juchong/EVAL-ADIS-FX3-Production-Test/images/disconnected.jpg

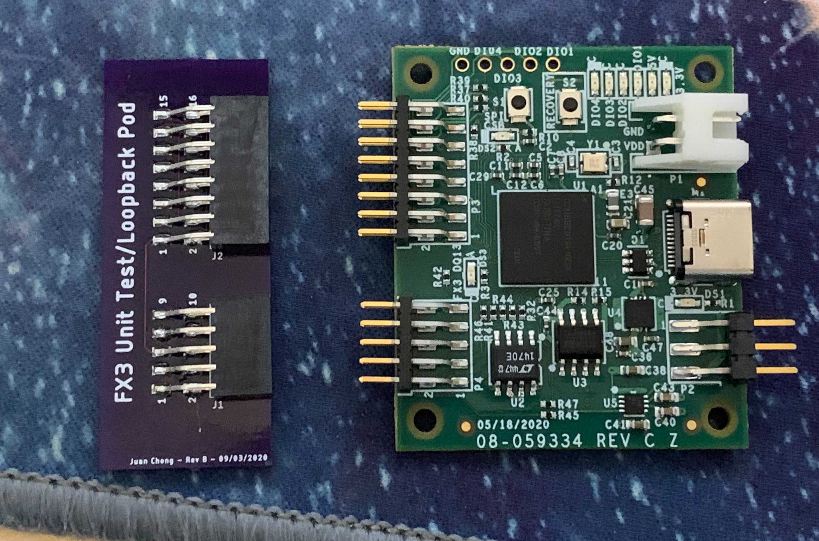
images/disconnected.jpg
