juchong/EVAL-ADIS-FX3-Production-Test/images/finished.PNG

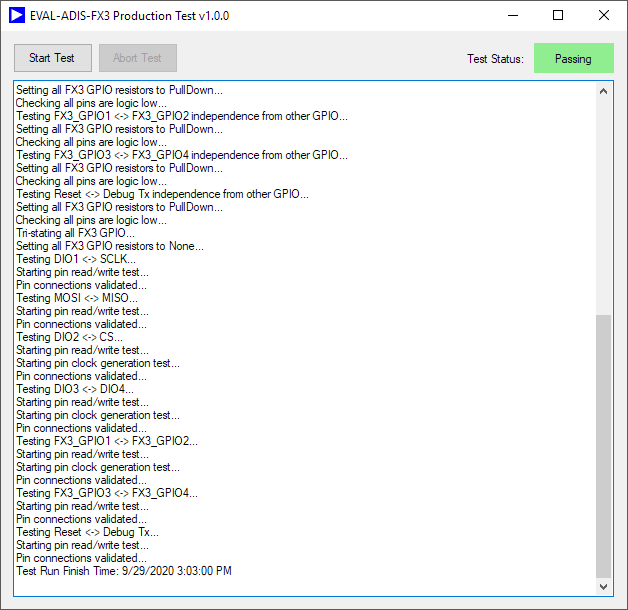
images/finished.PNG
