juchong/EVAL-ADIS-FX3-Production-Test/images/rebooting.PNG

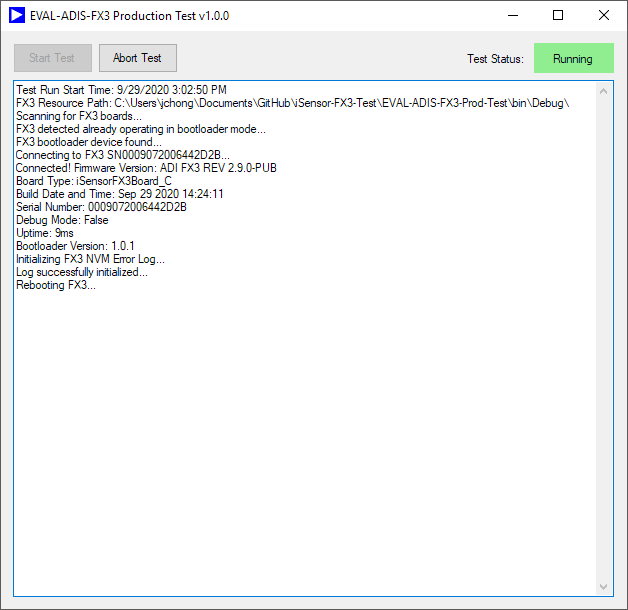
images/rebooting.PNG
