juchong/EVAL-ADIS-FX3-Production-Test/hardware/FX3 Unit Test Loopback Pod RevB BRD.pdf

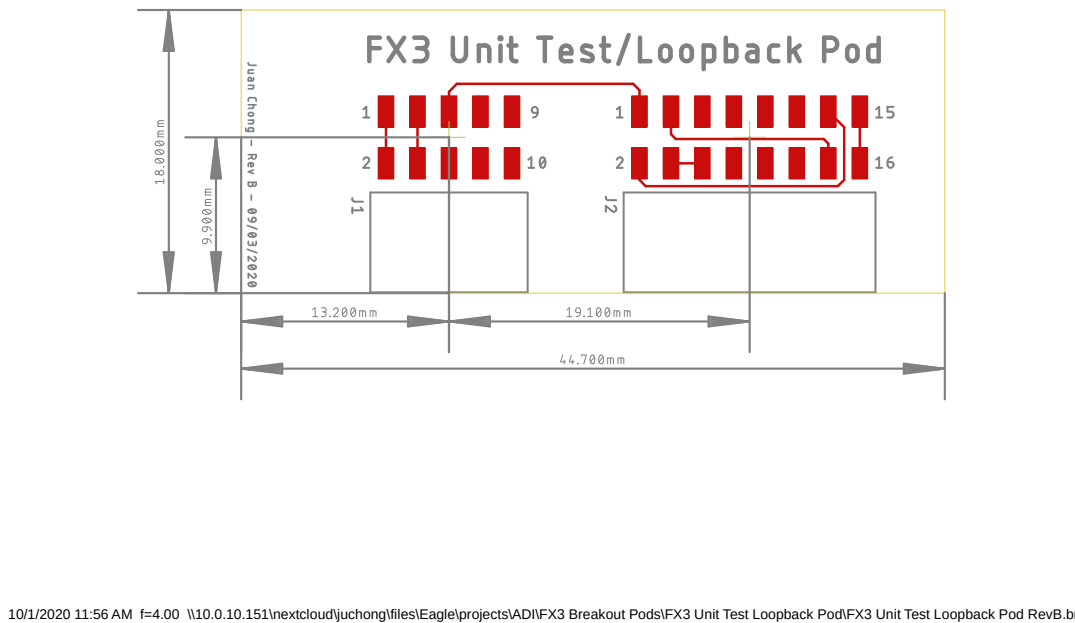
[picture p6: page 1]

10/1/2020 11:56 AM f=4.00 \\10.0.10.151\nextcloud\juchong\files\Eagle\projects\ADI\FX3 Breakout Pods\FX3 Unit Test Loopback Pod\FX3 Unit Test Loopback Pod RevB.brd
