juchong/EVAL-ADIS-FX3-Production-Test/hardware/FX3 Unit Test Loopback Pod RevB SCH.pdf

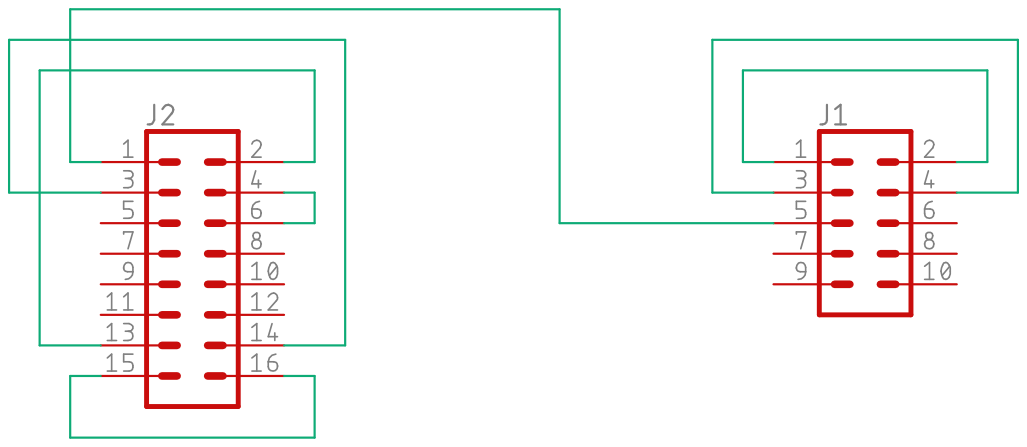
[picture p7: page 1]

10/1/2020 11:51 AM f=0.93 \\10.0.10.151\nextcloud\juchong\files\Eagle\projects\ADI\FX3 Breakout Pods\FX3 Unit Test Loopback Pod\FX3 Unit Test Loopback Pod RevB.sch (Sheet: 1/1)
