juchong/EVAL-ADIS-FX3-Production-Test/hardware/FX3 Unit Test Loopback Pod RevB.sch

## EAGLE design hardware/FX3 Unit Test Loopback Pod RevB.sch (2020-10-01)

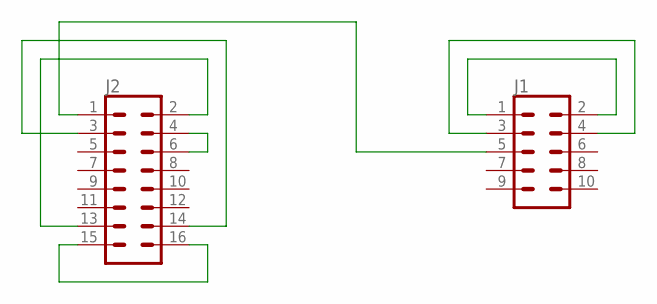
[picture p8: schematic FX3 Unit Test Loopback Pod RevB.sch]

Parts:
J1: CONN_05X2_2MM_FEMALE; M22-6550542R
J2: CONN_08X2_2MM_FEMALE; M22-6550842R

Connections:
unnamed: J2.4, J2.6
unnamed: J2.2, J2.13
unnamed: J2.3, J2.14
unnamed: J1.1, J1.2
unnamed: J2.15, J2.16
unnamed: J1.3, J1.4
unnamed: J1.5, J2.1
